lafalexis/projet_tournesol/Interface_Python/vegetation.jpg

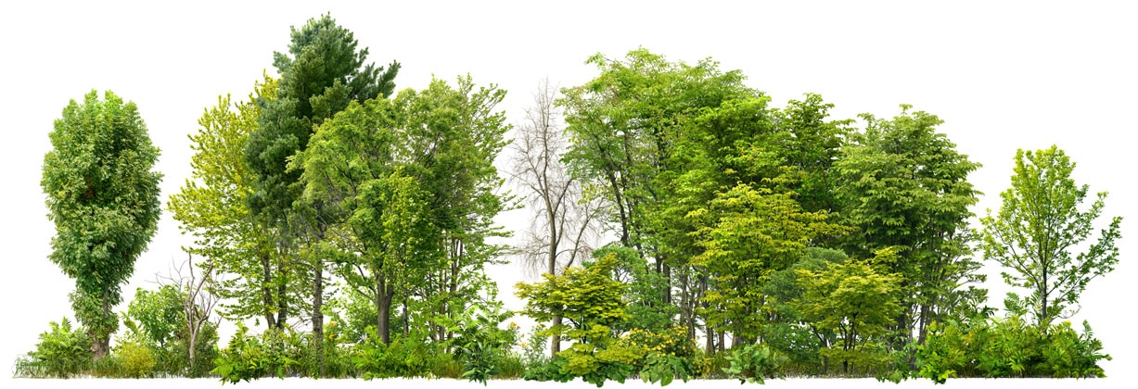
Interface_Python/vegetation.jpg
