lafalexis/projet_tournesol/README.md

# projet_tournesol
projet de fin d'étude en génie électrique
