lafalexis/projet_tournesol/Docs/class_diagram_sensor_module.png

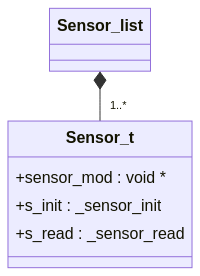
Docs/class_diagram_sensor_module.png
