lafalexis/projet_tournesol/Docs/rtd/op_amp_list.png

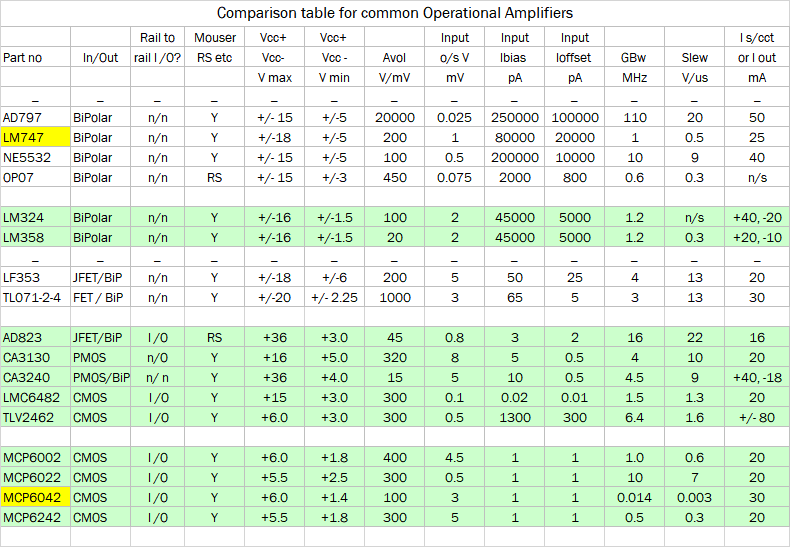
Docs/rtd/op_amp_list.png
