lafalexis/projet_tournesol/Docs/Anemometre/Journal_de_bord_anemometre.odt

# Fiche technique

- La tension à laquelle la composante fonctionne bien est entre 7 a 24 VDC.
- Le fil bleu est la sortie du signal, tandis que le fil brun et le fil noir est l’entrée de la source et la mise à la terre respectivement.
- La tension à la sortie du signal est varie entre 0.4V jusqu’a 2V qui ont la vitesse de vent équivalente de 0 m/s jusqu’a 32.4 m/s respectivement. (résolution de 0.1 m/s)

1. bits a tension

U = X \cdot (5 \cdot 1 / 1023)

U = x \cdot K1

2. tension a vitesse

équation linéaire

y = mx + b

m = \frac {V_2 – V_1}{U_2 – U_1} = (32.4 – 0)/(2 – 0.4) = 81/4

b = y – mx = V_1 – m \cdot U_1 = -81/10

V = m U + b

simplification :

V = m * (x \cdot K1) + b

V = x * (135/1364) – 81/10

V = x * (135/1364) – (81/10) = X * C1 – C2

C1 = 135/1364 = 0.098974

C2 = 81/10 = 8.1

0 1023 bits

0 5 volt

0.4 a 2 volt

x/1023 = 2/5

x = 2*1023/5 =

x = 0.4 * 1023/5 =

(x – bitmin) * windspeedmax / (voltagemax – voltagemin)

0 32.4 m/s
