lafalexis/projet_tournesol/Docs/rtd/Journal_de_bord_RTD.odt

# Caractéristique RTD

- le PT100 a une résistance de 100 ohm à 0 degrée celsius
- coefficient de température est de 3850 ppm/k (part per million / kelvin) .
- Si l’on veut calculer la resistance a une certaine température donnée, il est nécessaire d’utiliser les coefficient Callendar-Van Dusen. Pour le PT100, les coefficients sont :
- La formule pour déterminer la résistance pour une température qui est au dessus de 0 degrée C est celle-ci :
- La formule pour déterminer la résistance pour une température inférieur à 0 degrée C est celle-ci :
- Dans les formule précédante, R_T est la resistance recherché, R_0 est la résistance à 0 degrée celsius, les lettre A, B et C sont les coefficient du RTD PT100 et finalement T est la température.
- Pour notre RTD PT100, la résistance à 0 degrée C est de 100 Ohms

# Différente partie du circuit

Ressource :

- circuit du rtd

https://en.wikipedia.org/wiki/Resistance_thermometer

https://en.wikipedia.org/wiki/Wheatstone_bridge

https://www.instructables.com/Reading-Temperature-From-PT100-Using-Arduino/

https://www.ti.com/lit/an/sbaa275/sbaa275.pdf?ts=1646427900237&ref_url=https%253A%252F%252Fwww.google.com%252F

- amplification du signal

https://forum.arduino.cc/t/using-operational-amplifiers-in-your-arduino-project/692648/3

# Circuit du RTD

- La configuration du circuit choisi est la configuration a deux fils. Le capteur n’a que deux fils et agit simplement comme une resistance.
- Pour cette configuration, il faut monté un pont Wheatstone qui permet de lire la resistance du RTD de facon précise.
- il nous faut 3 resistance, ainsi qu’une source d’alimentation.
- on peut ensuite lire la valeur de la tension sur la sortie du pont qui est égal a un ratio entre les résistances (diviseur de tension).
- Les 2 résistance à l’entrée vont être utilisé pour limiter le courant en entrée du pont. Puisque nous utiliseron la source de 5 V du Arduino et qu’on limitera le courant à 2.2 mA :
- la troisième resistance, elle doit être une valeur un peu du minumum plus bas de la plage de mesure.
  - La plage de mesure pour le capteur sera entre 0 degrée et 40 degrée
  https://www.sciencedirect.com/science/article/pii/S2212094715300116
  - Il faut alors trouver les valeur de resistance pour le maximum et le minimum.
  - Pour le minimum, la température égale a 0 degrée, la resistance est a 100 ohm
  - pour le maximum, il faut alors utiliser la formule pour trouver la resistance :
- La troisieme resistance doit être inférieur de 100 ohm. Pour distinguer la valeur, nous avons choisis un resitance de 68 ohms

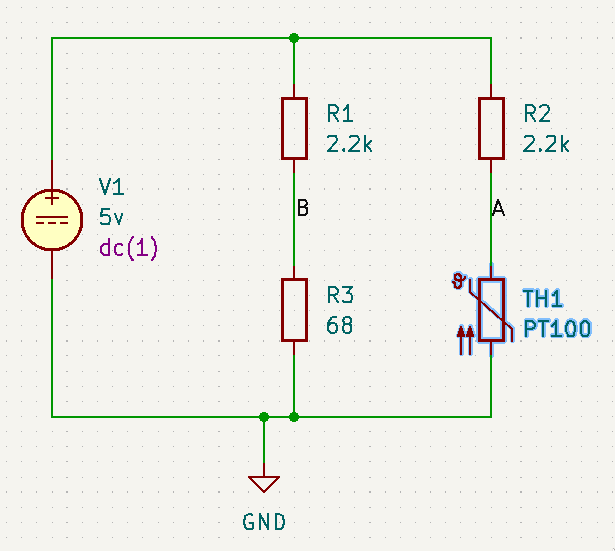
[picture p4: figure]

Le logiciel KiCad contient un outil de simulation basée sur le simulateur Ngspice. On peut alors simuler les circuit pour mesurer les tension theorique sur Va et Vb. Pour ce faire, nous alons simuler la variation de resistance en remplacent le capteur PT100 par une resistance qui varie entre 100 ohm et 116 ohms par une incrémentation de 1 ohm.

résultat simulation avec PT100 à 100 ohm :

Initial Transient Solution

Node Voltage

/b 0.149912

net-_r1-pad1_ 5

/a 0.217391

résultat simulation avec PT100 à 115.541 ohm :

Initial Transient Solution

Node Voltage

/b 0.149912

net-_r1-pad1_ 5

/a 0.24949

Voici le graphique représentant la tension sur Va par rapport à la variation de resistance de la resistance qui remplace le capteur PT100 :

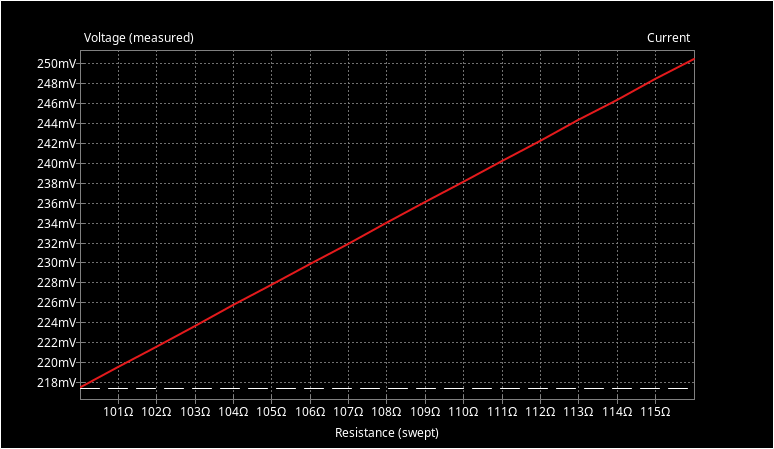
[picture p5: figure]

Nous remarqu’on une différence entre la valeur minimal et maximale de 0.032099. cette différence est très petite pour le convertiseur ADC de l’Arduino. Il nous faut alor amplifier ce signal.

# Circuit d’amplification de signal

Il faudra monter un amplificateur differentiel pour avoir une différence entre les deux tension de sortie ainsi qu’une amplification du signal.

Cependant, pour ne pas affecter le circuit antérieur, il nous faut mettre des amplificateur suiveur. La caractéristique principale de ce type d’amplificateur est qu’elle a théoriquement une impédance infini à l’entrée et une petite impédance de sortie. Ainsi le circuit à pont ne sera pas affecter du à cette impédance d’entrée.

puisque nous avons un différence de 0.032099, sans amplification nous verons pas de différence lors de changement de température. Il faut au minimum un plage de 2V.

2/0.032099 = 62.3072

Il faudrait alors avoir un gain d’environ 60. Cependant, sachant que la tension la plus haute à la sortie du pont est d’environ 0.25 V, si l’on l’amplifie par 60, nous obtiendron une tension de 15 volt qui dépasse la source de tension de 5 V. On choisi alors un gain inférieur d’environ 40.

Vout = (Vb - Va) (r2 / r1)

Sachant le gain que nous voulons, nous pouvons alors déterminer les valeurs des resisteurs.

pour ce faire il faut une petite resistance R1. Prenons 1k Ohm pour celui, une valeur standard commune. On peut alors trouver R2 :

# Montage de circuit

Le choix de l’ampli op à du être choisi en fonction de la source de tension disponible à partir de l’Arduino. Il fallait alors un ampli op pouvant fonctionner sur une tension de 0 à 5V. Il existe alors des ampli op concu pour ce type de tension à source unique. Nous avons décider de choisir le MCP6042.

## Vérification du fonctionnement du circuit

Avant d’utiliser le capteur PT100, il possible d’imiter la réaction au changement de température du capteur par simplement remplacer le capteur par un potentiomètre. Ainsi, nous pouvon confirmer si le circuit est bien fonctionnel par simplement faire varier la resistance du potetiomètre.

procedure pour tester le circuit :

1. monter le circuit exactement comme le diagramme de circuit

2. remplacer le rtd par une résistance variable :

* dans mon cas, pour augmenter la précision, j’ai remplacer par un potentiometre de 500 ohm suivi d’une resistance de 190 ohm, le tout en parallele avec une resistance de 220 ohm. Theoriquement, le potentiometre varie la resistance entre 101.95 ohm et 166.81

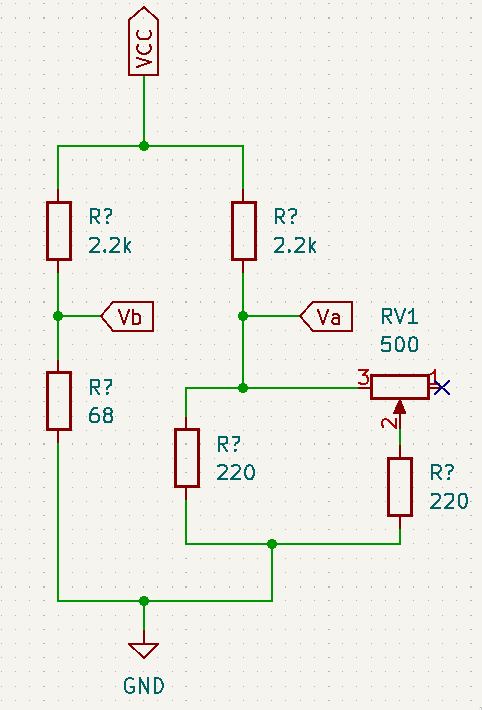
[picture p6: figure]

3. Ensuite alimenté le circuit

4. A l’aide d’un multimètre, mesuré la tension sur Va

5. varier le potentiomètre pour obtenir les tension obtenue lors de la simulation (min : 0.217391 et max :0.24949)

6. Mesurer la tension à la sortie du circuit

| Va | Sortie
minumum | 0.216 | 3.09
maximum | 0.249 | 4.30
Différence (max-min) | 0.033 | 1.21

Tension pris du circuit montée

7. calcul du gain pratique

G = 36.667

qui est proche au gain théorique de 40

## Verification du fonctionnement du capteur PT100

### Test du capteur à l’aide d’eau glacée

Il faut alors tester le capteur avec des référence de température d’être sur de connaitre. Il existe une méthode qui permet d’avoir une température d’eau fixe. Cette méthode consiste a plonger le capteur dans de l’eau avec de la glace. La température est alors stabiliser à 0 degree celsius puisque l’eau est entre deux états : solide et liquide.

Resultat :

2.77

2.80

2.79

La resistance à cette température est de 100 ohm

### Test du capteur à température ambiante

Nous allon refaire le même prise de mesure mais pour le température ambiante. Nous pouvons pas déterminer précisément la température ambiante mais nous pouvon mesurer la resistance du capteur comme mesure précise. Pour ce faire il faut :

1. laisser le capteur s’adapater à la temperature ambiante.

2. lire la tension au à la sortie du circuit

3. déconnecter le capteur et rapidement prendre la resistance du capteur PT100 comme référence.

Tension mesuré : 3.34 V

R : 106.4 Ohm

Tableau résumé des prise de mesure

| Tension (V) | Resistance (Ohm) | Température (degrée C)
Test de glace | 2.77 | 100 | 0
Température ambiant | 3.34 | 106.4 | x

La température ambiante peut être trouver connaissant la resistance.

Environ 16.5 degree celsius

# Programmation du Module PT100

Le module du capteur de température est subdiviser en deux fichiers : PT100.cpp et PT100.h

L’entête contient la classe PT100 qui contient les méthodes qui intéragit avec le capteurs. Celui ci intéragit par le moyen du convertisseur ADC de l’arduino.

## Conversion des données

La plage de tension du ADC varie entre 0 V et 5V et on sait aussi que la precision de ce convertisseur est de 10-bit. De plus les valeur que nous mesuron sont les tension à la sortie de notre circuit. Il faut alors faire le calcule qui permet de convertir cette tension en resistance du PT100. Finalement il nous faut que simplement convertir cette resistance en température à l’aide de nos calcul précédent. Voici les étape que le doit faire pour convertir les bit en temperature :

1. bits a tension

V = X \cdot (5 \cdot 1/1023)

V = X \cdot K1

ou V est la tension calculé

X est la mesure en bits

2. tension a resistance

V_2 = 3.34 V

V_1 = 2.77 V

R_2 = 106.4 Ohm

R_1 = 100 Ohm

connaissant 2 point de référence, on peut tout simplement utiliser un modèle d’équation lineaire comme représentation. Il faut alors trouver la pente ainsi que l’ordonnée à l’origine.

y = mx + b

m = \frac {R_2 – R_1}{V_2 – V_1} = 640/57 = 11.2281

b = y – mx = R_1 – m \cdot V_1 = 19636/285 = 68.8982

Nous obtenon alors la regle ci dessous pour transferer de tension à resistance :

R = m V + b = (11.2281) V + (68.8982)

3. resistance a temperature

Il est possible d’utiliser la formule qui utilise les variables de Callendar-Van Dusen pour déterminer la valeur de température par rapport à la résistance. Cependant, puisque cette équation peut demandé des beaucoup de ressource de calcul ainsi que l’énergie, il faut alors une équation approximatif de celle-ci. On peut utiliser l’équation suivante :

T = \frac {\frac {R_x}{R_0} - 1}{\alpha}

où :

\alpha : Le coefficient de température et resistance du RTD. Le notres est égal à environ 0.00385 (PT100)

R_x : La resistance mesuré

R_0 : La resistance à 0 degrée C

T = \frac {\frac {R}{100} – 1}{0.00385} = \frac {200}{77} \cdot (R - 100)

## Simplification de la conversion

Il est préférable de faire le moin de calcule possible lors de l’execution du programme. Il est alors possible de diminuer le nombre de calcul on fussionnant certaines étape. De plus, on évite les erreur de calcul qui peuvent s’additionner d’une étape à l’autre :

Fusion d’étape 1 et 2 :

On peut alors appliqué la conversion de l’étape 1 à la conversion de l’étape 2 et nous obtenon une règle permetant de faire le transfert de bit à resistance :

R = m V + b = m (X \cdot K1) + b = (640/57) \cdot (X \cdot (5/1023)) + (19636/285)

R = K_2 \cdot X + K_3 = (3200/58311) X + (19636/285)

Fusion d’étape 1/2 et étape 3 :

On peut aussi fusionner notre formule entérieur a celle de l’étape 3 pour avoir une seul formule permettant de faire la conversion d’une mesure en bit directement en température :

T = \frac {200}{77} \cdot (R – 100) = \frac {200}{77} \cdot ((K_2 \cdot X + K_3) – 100)

T = \frac {200}{77} \cdot (((3200/58311) X + (19636/285)) – 100)

T = \frac {1280}{4489947} \cdot (500 \cdot X – 283371)

T = K_4 \cdot (K_5 \cdot X – K_6)

K_4 = 1280/4489947

K_5 = 500

K_6 = 283371

En simplifiant encore plus

T = \frac {1280}{4489947} \cdot (500 \cdot X – 283371) = 0.142541 \cdot (X – 566.742)

T = C_1 (X – C_2)

C_1 = 0.142541

C_2 = 566.742

on peut alors décrire les étapes de conversions lors d’une prise de mesure :

1. On mesure la temperature et l’ADC nous retourne un int (0 à 1023)

2. on applique notre formule à l’aide des constante C1 et C2

3. on retourne cette valeur qui équivaut a la température en Celsius
