lafalexis/projet_tournesol/Docs/maincircuit/schematic/Main_circuit_version_1.2.pdf

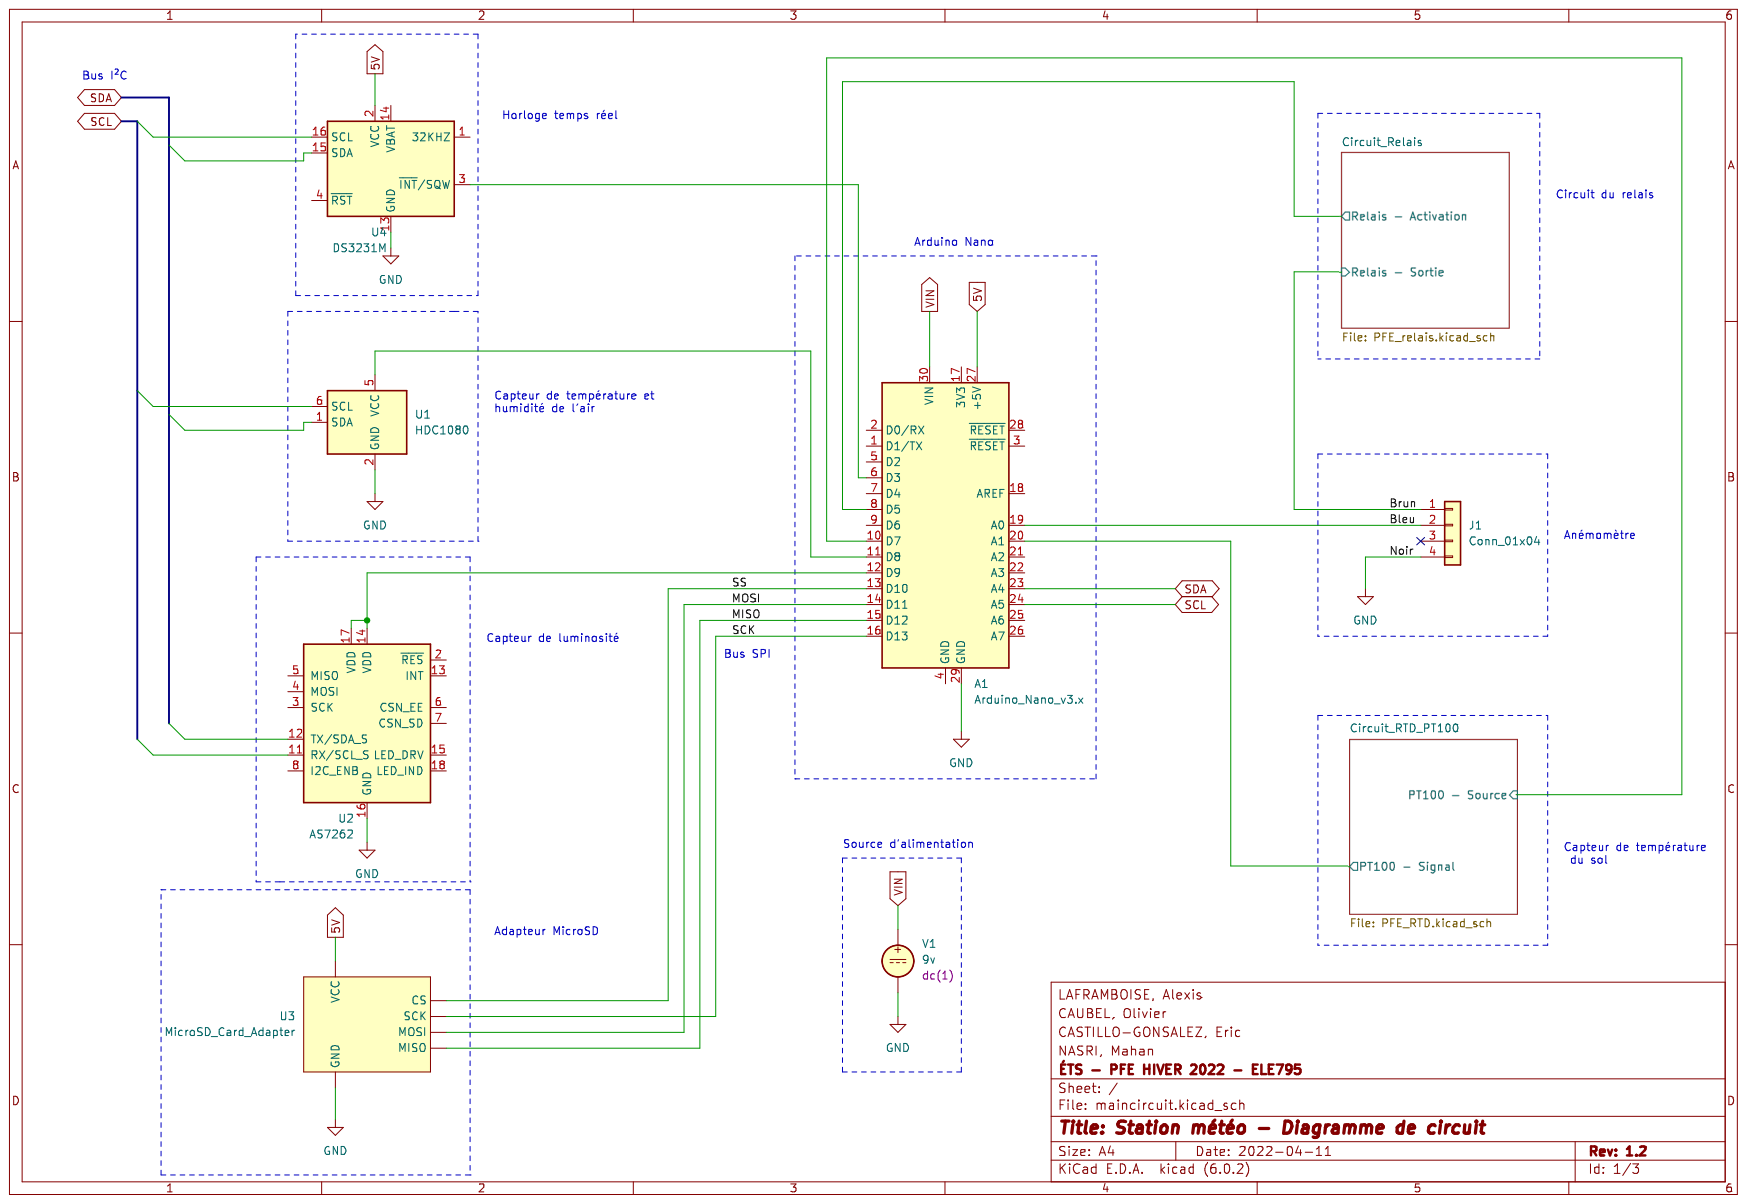
[picture p7: page 1]

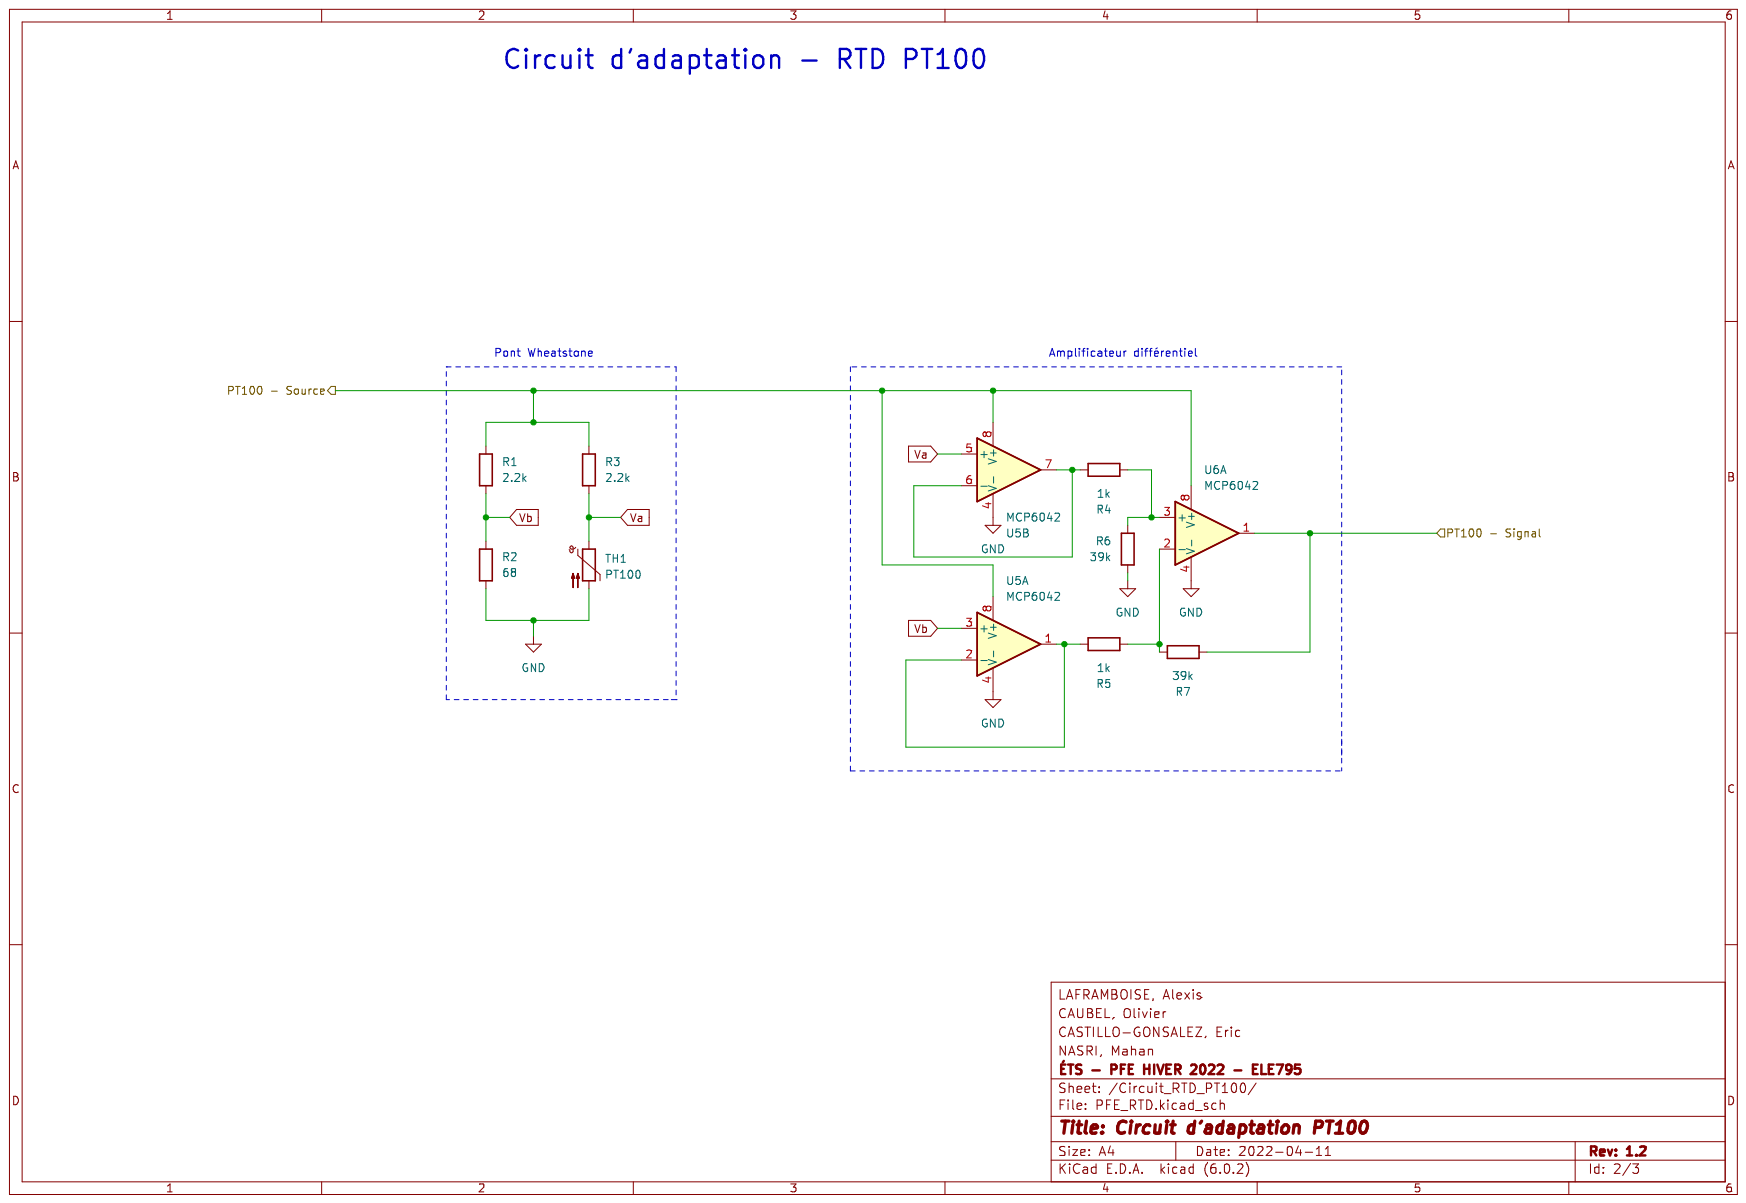
[picture p8: page 2]

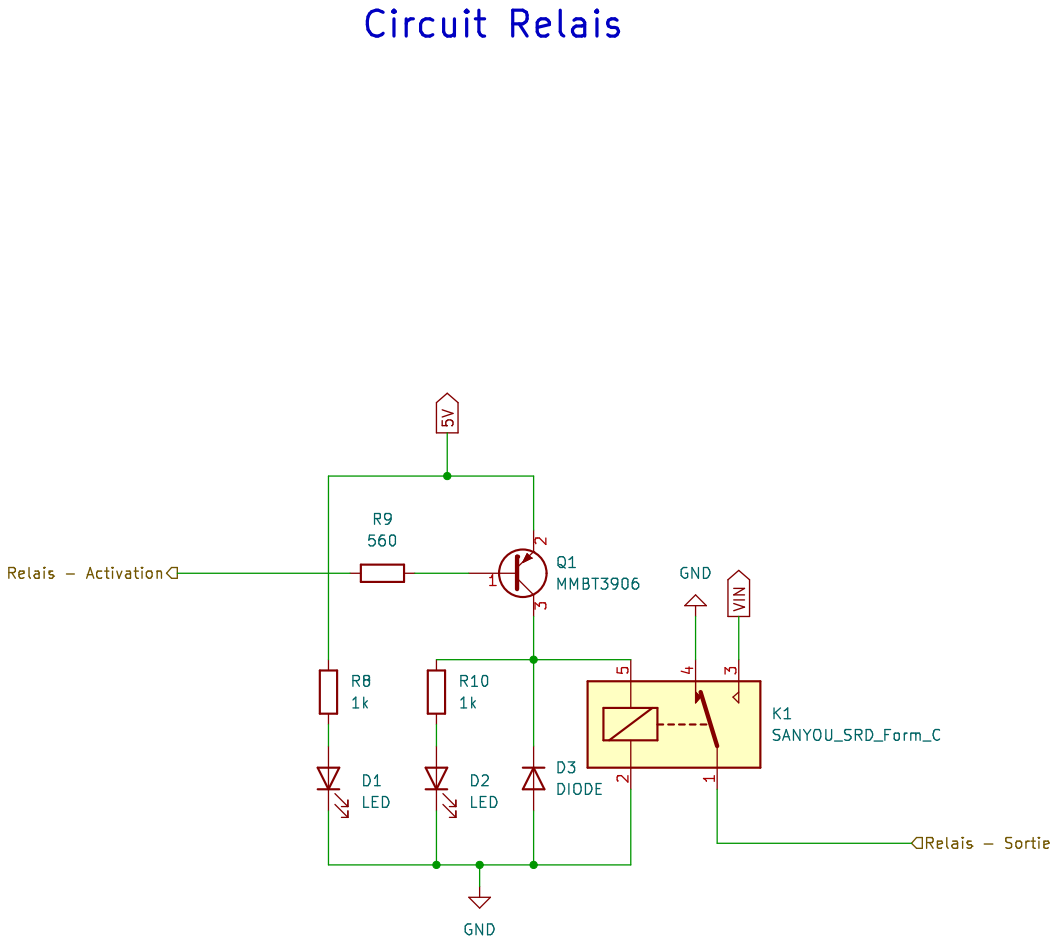
[picture p9: page 3]
