lafalexis/projet_tournesol/Docs/rtd/schematic/circuit_RTD_version1.pdf

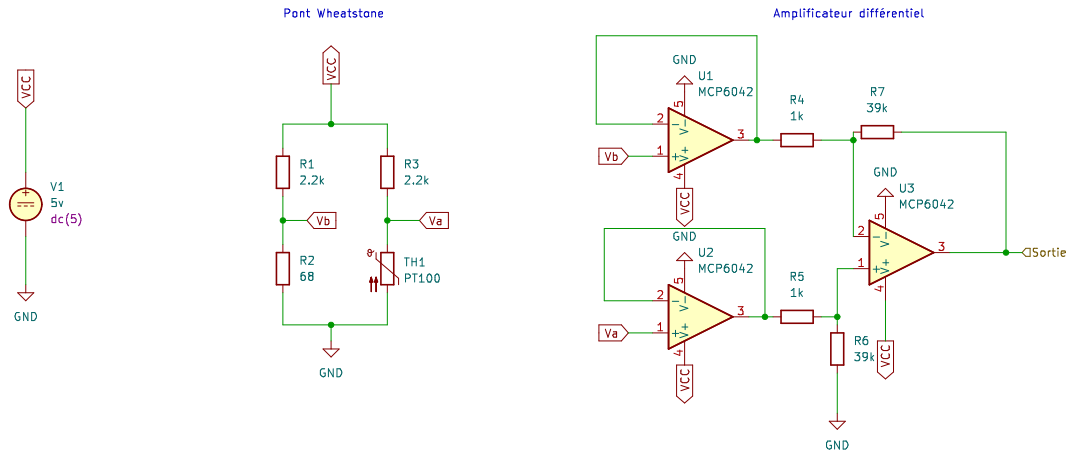
[picture p10: page 1]
