lafalexis/projet_tournesol/Docs/maincircuit/schematic/Main_circuit_version_1.1.pdf

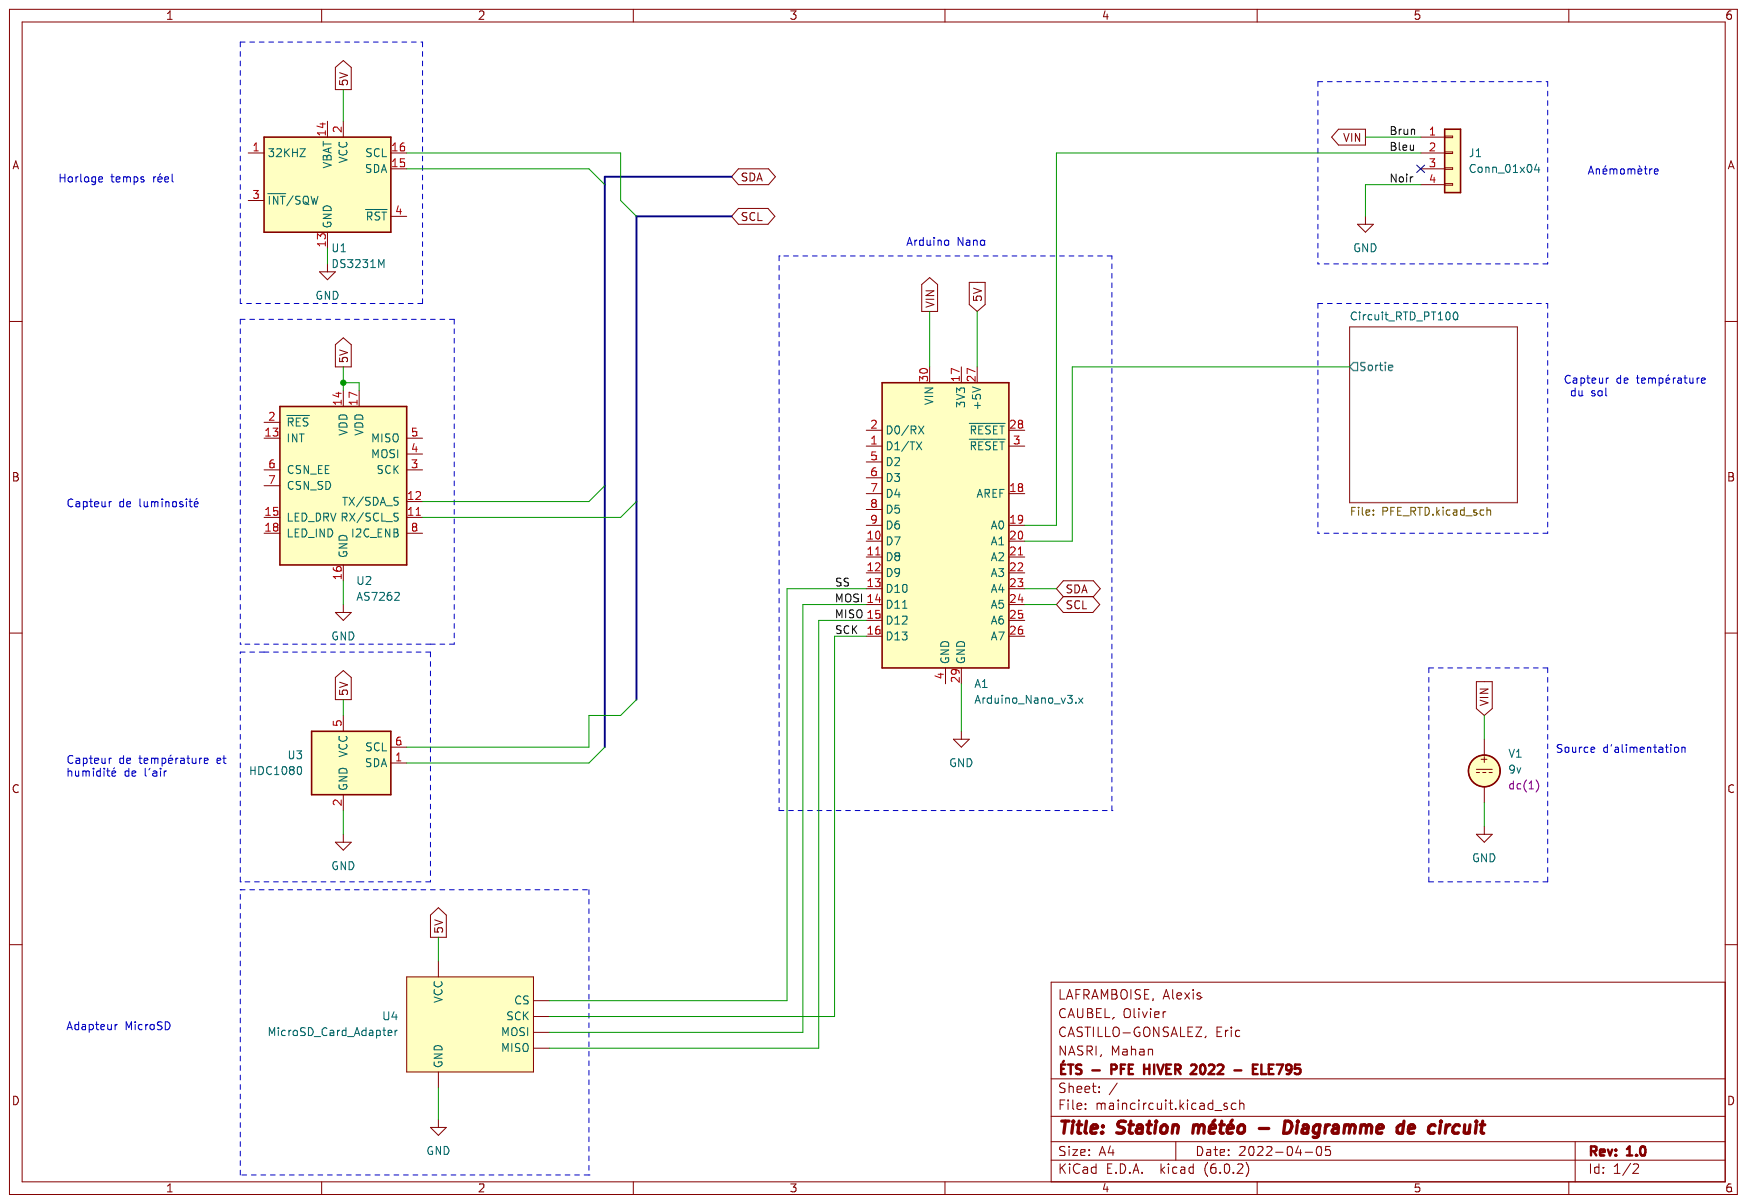
[picture p11: page 1]

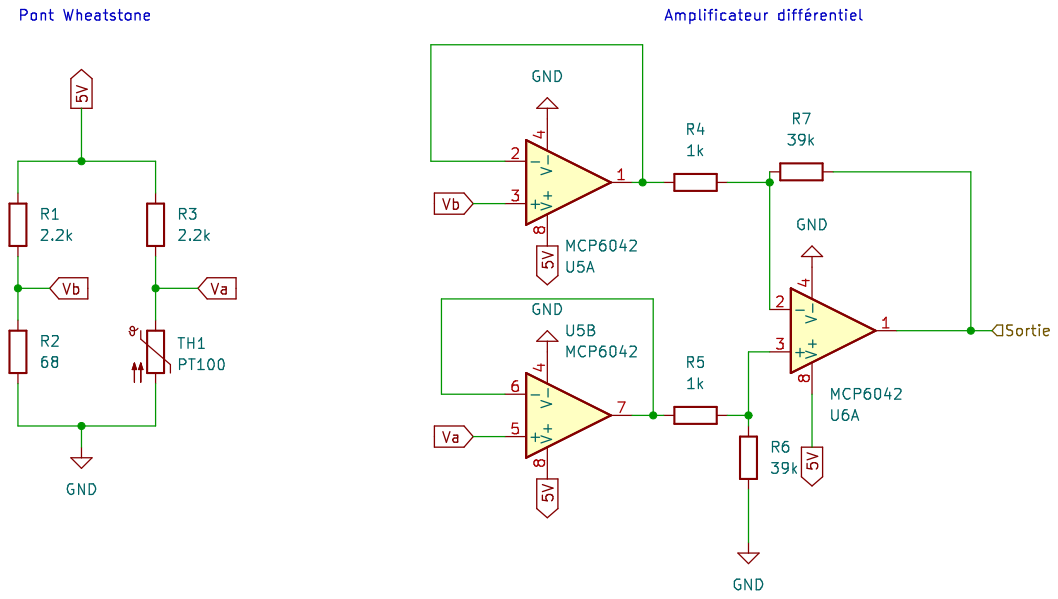
[picture p12: page 2]
