lafalexis/projet_tournesol/Docs/maincircuit/schematic/Main_circuit_version_1.0.pdf

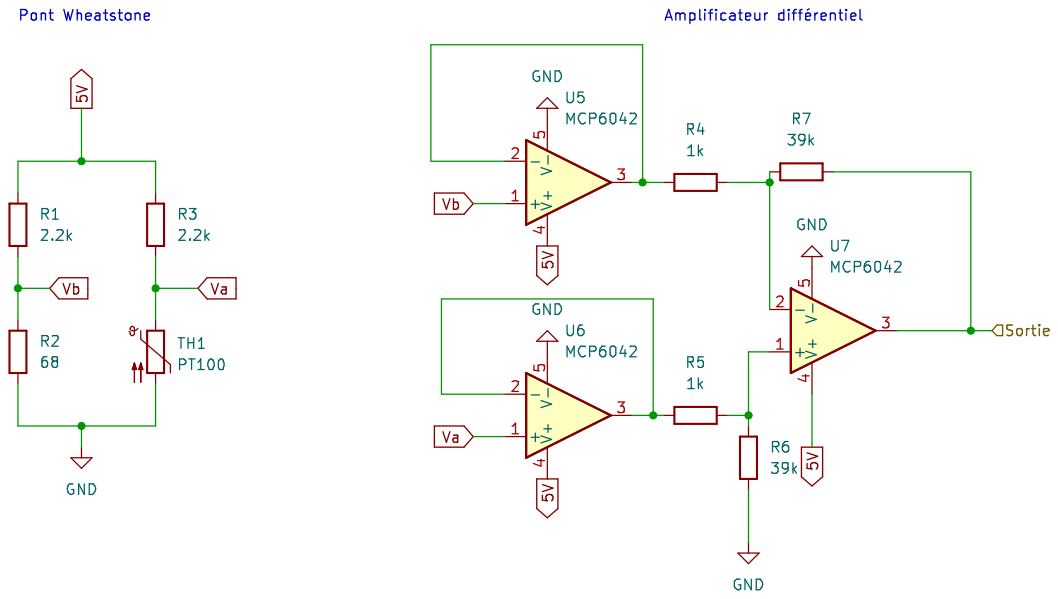
[picture p13: page 2]
