lafalexis/projet_tournesol/Docs/maincircuit/schematic/Main_circuit_version_0.2.pdf

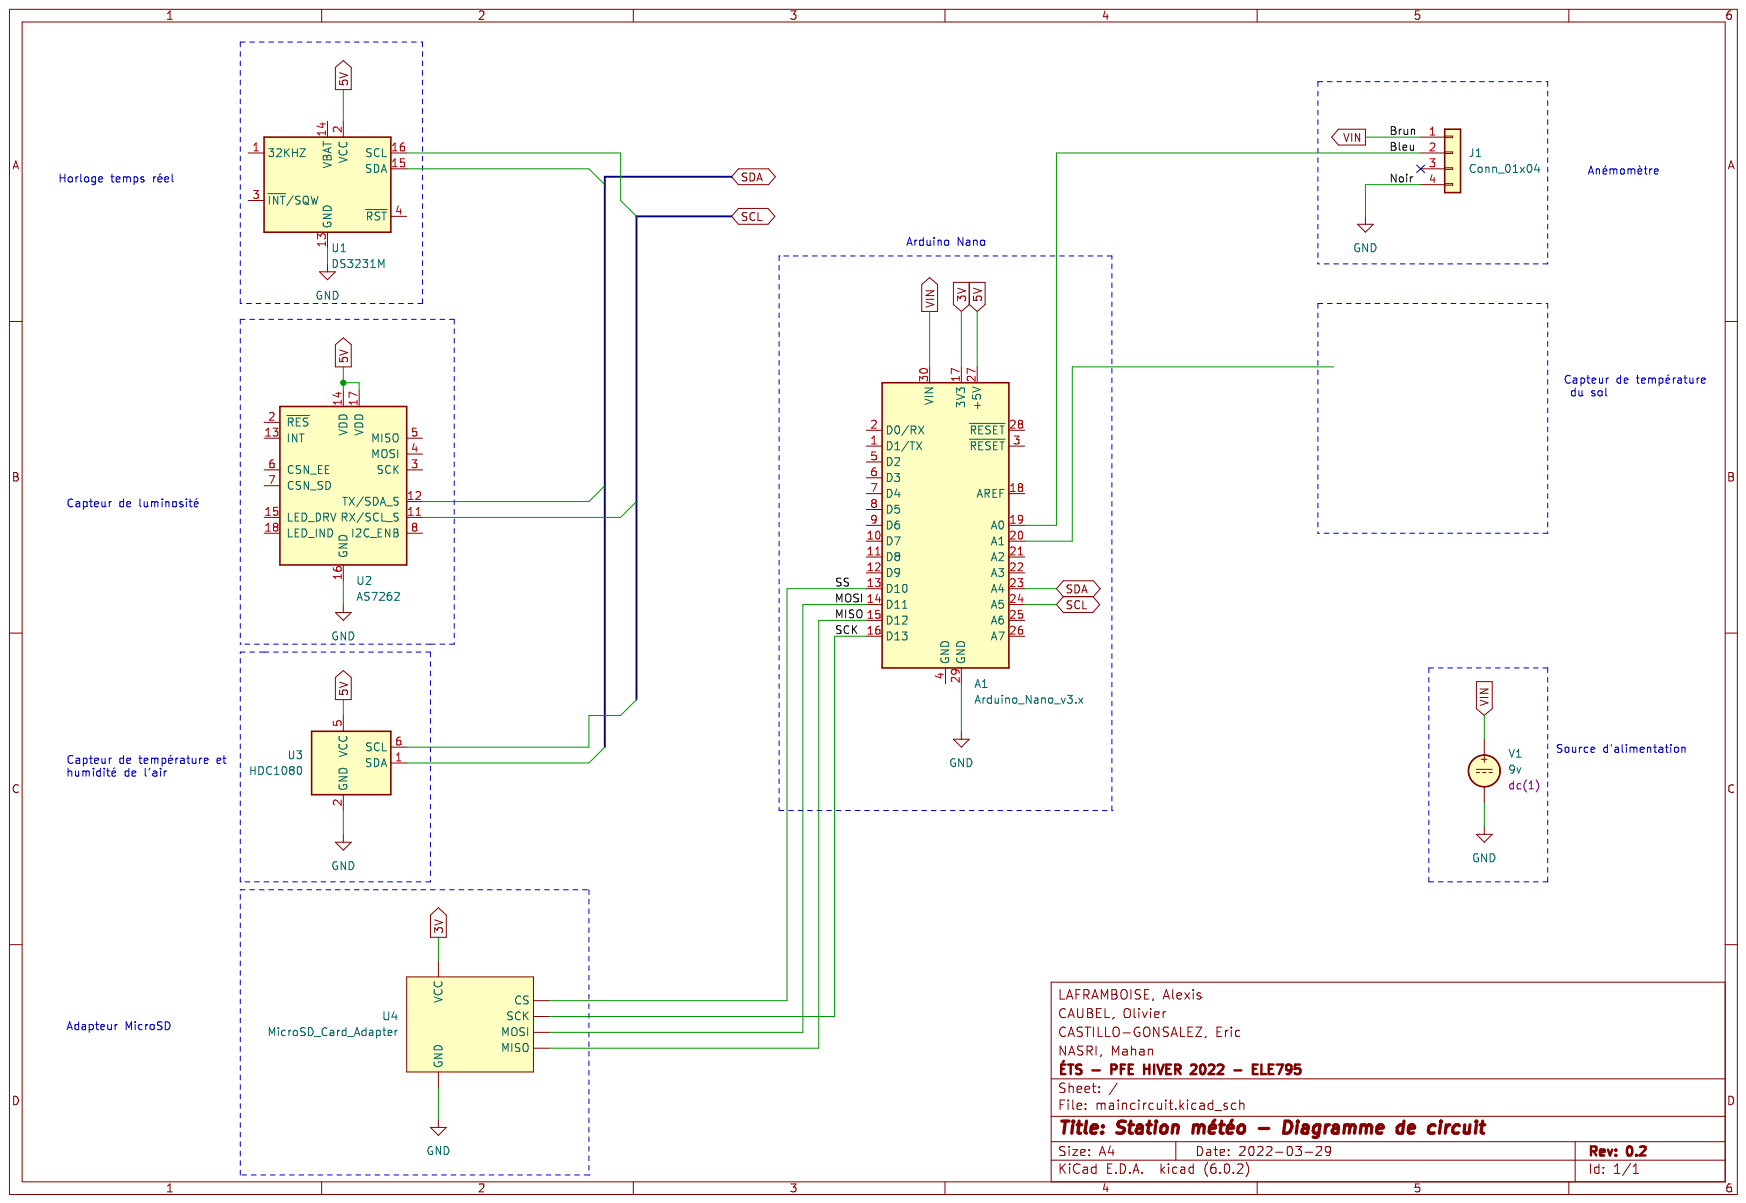
[picture p14: page 1]
