lafalexis/projet_tournesol/Docs/maincircuit/schematic/kicad/maincircuit/PFE_RTD.kicad_sch

## KiCad design Docs/maincircuit/schematic/kicad/maincircuit/PFE_RTD.kicad_sch (2022-04-07)

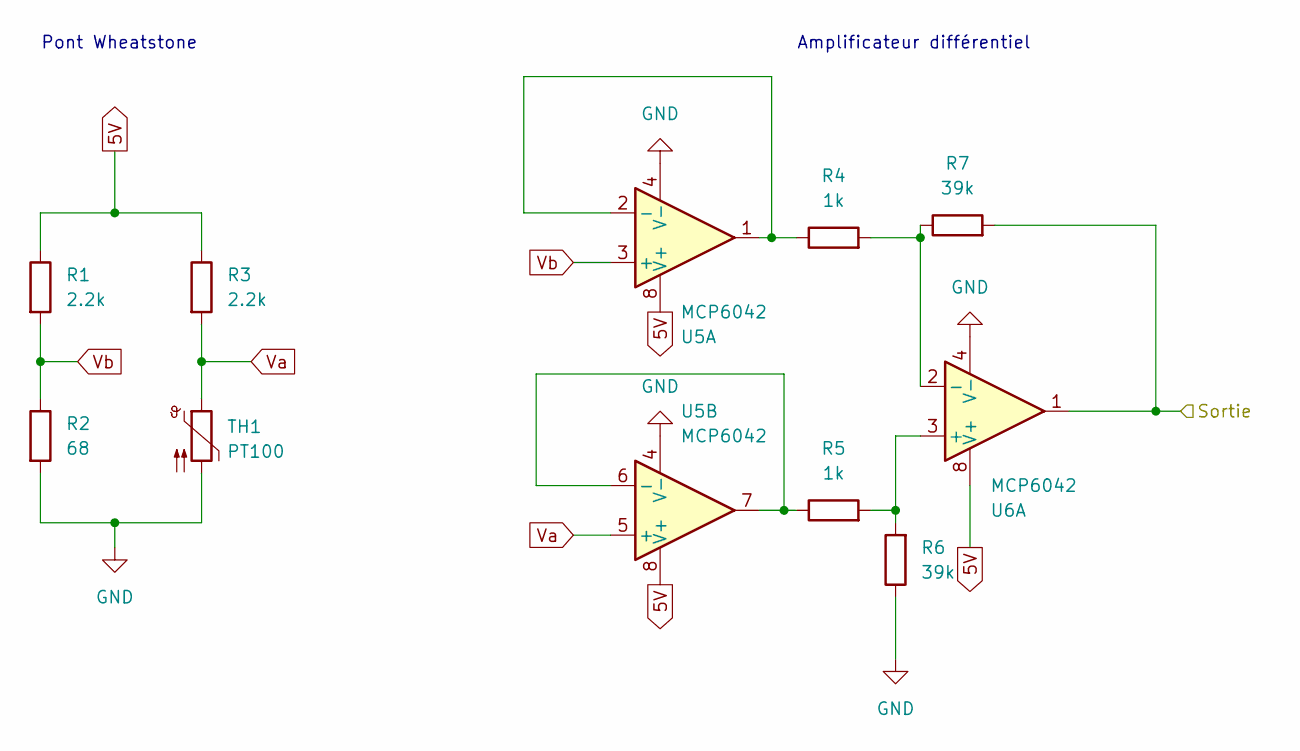
[picture p15: schematic PFE_RTD.kicad_sch]

Parts:
R1, R3: 2.2k
R2: 68
R4, R5: 1k
R6, R7: 39k
TH1: PT100
U5, U6: MCP6042

Connections:
5V: R1.1, R3.1, U5.8 (V+), U6.8 (V+)
GND: R2.2, R6.1, TH1.2, U5.4 (V-), U6.4 (V-)
unnamed: R4.1, U5.1, U5.2 (-)
unnamed: R4.2, R7.1, U6.2 (-)
unnamed: R5.1, U5.6 (-), U5.7
unnamed: R5.2, R6.2, U6.3 (+)
Sortie: R7.2, U6.1
Va: R3.2, TH1.1, U5.5 (+)
Vb: R1.2, R2.1, U5.3 (+)

Notes on the sheet:
Pont Wheatstone
Amplificateur différentiel
