lafalexis/projet_tournesol/Docs/maincircuit/schematic/kicad/maincircuit/maincircuit.kicad_sch

## KiCad design Docs/maincircuit/schematic/kicad/maincircuit/maincircuit.kicad_sch (2022-04-07)

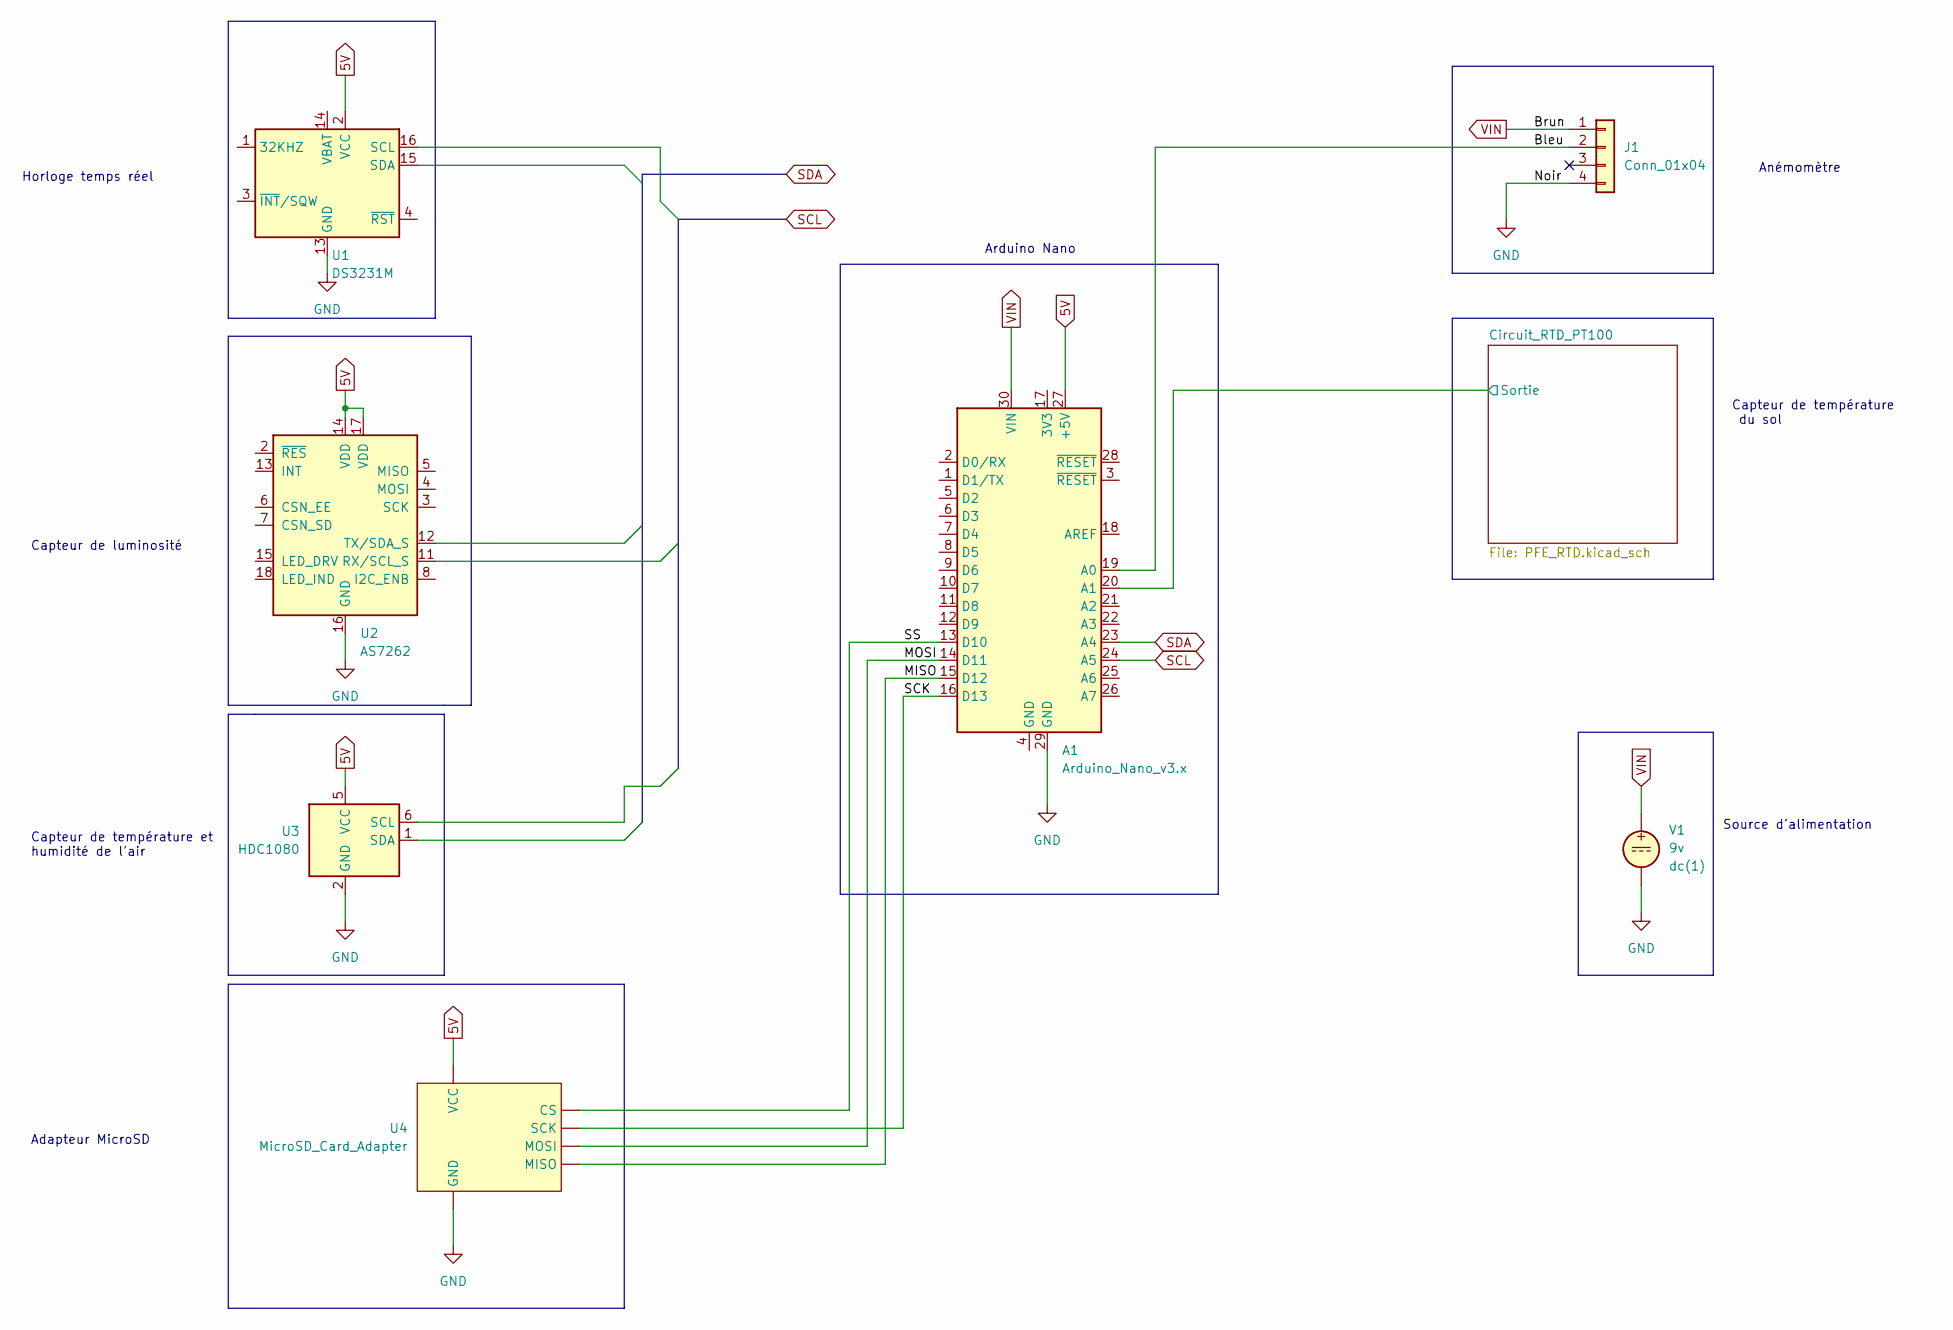
[picture p16: schematic maincircuit.kicad_sch]

Parts:
A1: Arduino_Nano_v3.x; Arduino_Nano
J1: Conn_01x04
U1: DS3231M; SOIC-16W_7.5x10.3mm_P1.27mm
U2: AS7262; AMS_LGA-20_4.7x4.5mm_P0.65mm
U3: HDC1080; Texas_PWSON-N6
U4: MicroSD_Card_Adapter
V1: 9v

Connections:
5V: A1.27 (+5V), U1.2 (VCC), U2.14 (VDD), U2.17 (VDD), U3.5 (VCC), U4.
Bleu: A1.19 (A0), J1.2
GND: A1.29 (GND), J1.4, U1.5 (GND), U1.6 (GND), U1.7 (GND), U1.8 (GND), U1.9 (GND), U1.10 (GND), U1.11 (GND), U1.12 (GND), U1.13 (GND), U2.16 (GND), U3.2 (GND), U4., V1.2
MISO: A1.15 (D12), U4.
MOSI: A1.14 (D11), U4.
SCK: A1.16 (D13), U4.
SCL: A1.24 (A5)
SDA: A1.23 (A4)
SS: A1.13 (D10), U4.
Sortie: A1.20 (A1)
VIN: A1.30 (VIN), J1.1, V1.1

Notes on the sheet:
Anémomètre
Capteur de température du sol
Horloge temps réel
Capteur de température et humidité de l'air
Arduino Nano
Capteur de luminosité
Adapteur MicroSD
Source d'alimentation
