lafalexis/projet_tournesol/firmware_tournesol/firmware_tournesol/ArduinoCore/include/connections.h

/*
 * connections.h
 *
 * Created: 2022-04-01 9:37:23 AM
 *  Author: aplaf
 */


#ifndef CONNECTIONS_H_
#define CONNECTIONS_H_

/* Connected pins */
/* Outputs */
#define ERROR_LED_PIN		(2)
#define RELAY_9V_PIN		(5)

#define PT100_POWER_PIN		(7)
#define HDC1080_POWER_PIN	(8)
#define AS7262_POWER_PIN	(9)

/* Inputs */
#define DS3231_EXTINT_PIN	(3)
#define ANEMO_ADC_PIN       (A0)
#define PT100_ADC_PIN       (A1)


#endif /* CONNECTIONS_H_ */
