lafalexis/projet_tournesol/(commit log)

2022-02-12 basic project structure, device header file and datasheet added
2022-03-06 added checksum for each frame, error management and some refactoring
2022-03-06 Rev 2
    [DataBase.xlsx]
2022-03-08 fixed issue with writing datetime to memory
    [common.h]
2022-03-09 rtd schematic and ressource added
    [PFE_RTD.kicad_pcb, PFE_RTD.kicad_sch, lm741.dsn, lm741.opj]
2022-03-10 comment added in main.ino; revision 0.1 RTD PT100 schematic
    [PFE_RTD.kicad_sch]
2022-03-10 Journal de bord RTD updated : adaptation circuit working
2022-03-14 RTD PT100 class method created; init and read functions on main.ino added (PT100); Journal de bord updated
2022-03-14 RTD PT100 working : main.ino rtd sensor init and read working, PT100 module working, and Journal de bord updated
2022-03-18 utils updated
    [DataBase.xlsx]
2022-03-18 rev 3
    [DataBase.xlsx]
2022-03-28 migrated from arduino ide to microchip studio
2022-03-28 lecture de mesure raw fonctionnel
2022-03-29 ajout du diagramme de circuit principale, non-fini (version 0.1)
    [maincircuit.kicad_pcb, maincircuit.kicad_sch]
2022-03-30 ajout de la conversion des donnée; ajout du journal de bord (calcul)
2022-03-30 ajout de Docs/Anemometre
2022-03-30 modif sd source 3V; enlever pullup ; revision 0.2
    [maincircuit.kicad_sch]
2022-03-30 enlever les doc par rapport a LM741cn
    [lm741.dsn, lm741.opj]
2022-03-30 replace les fichier cpp au bon dossier; correction : choix des pin pour les capteur ADC (PT100 et ANEMO)
    [PT100.cpp, PT100.h, anemometer.cpp]
2022-03-30 ajout pdf circuit principale
2022-03-30 ajout pdf circuit principale dans Doc/maincircuit/schematic/
2022-04-02 commented, integrated pt100 and anemometre and cleaned up everything
    [database.xlsx]
2022-04-05 mise a jours du diagramme de circuit - revision 1.0
    [PFE_RTD.kicad_sch, maincircuit.kicad_sch]
2022-04-05 version pdf du circuit ajouté (revision 1.0)
2022-04-07 import serial s = serial.Serial('COM3', baudrate=9600, bytesize=8, stopbits=serial.STOPBITS_ONE) data = [] while 1: data.append(println := s.read()) if b''.join([println]).decode('utf-8') == "\n": lo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
    [Serial_monitor.py]
2022-04-07 correction pour les pin des MCP6042; generer le bom
    [PFE_RTD.kicad_sch, maincircuit.csv, maincircuit.kicad_sch]
2022-04-08 suppresion de header qui était dans le mauvais répertoire
2022-04-09 ajout du flow chart principale
2022-04-09 ajout de class_diagram_sensor_modules.png
2022-04-11 fixed modules init and exec stability issue
    [database.xlsx]
2022-04-11 calibrated as7262, rtd and anemo
